nielsbosmans87/bomb-busters/detonator/out/panel_engrave.png

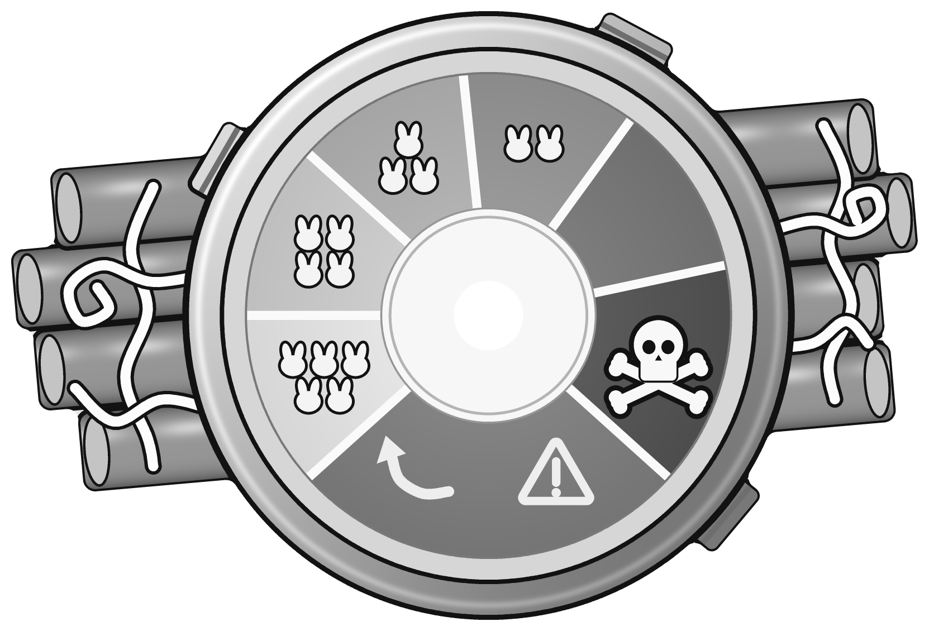
detonator/out/panel_engrave.png
