nielsbosmans87/bomb-busters/docs/picture_detonator.jpg

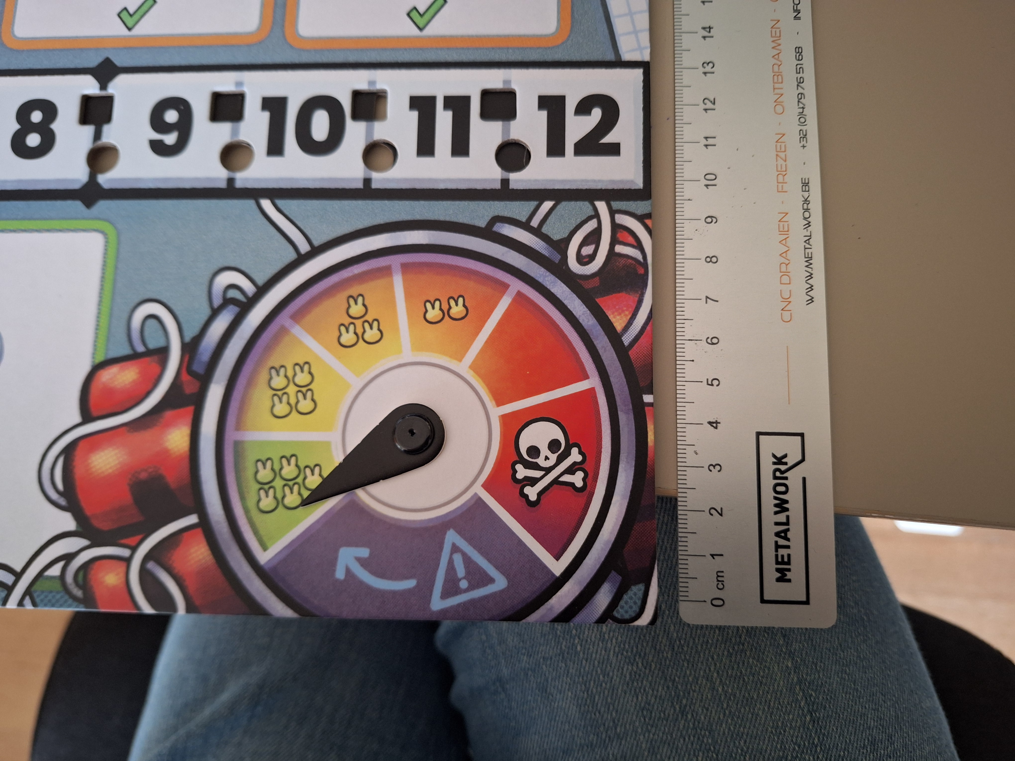
docs/picture_detonator.jpg
