nielsbosmans87/bomb-busters/detonator/cad/detonator.FCStd

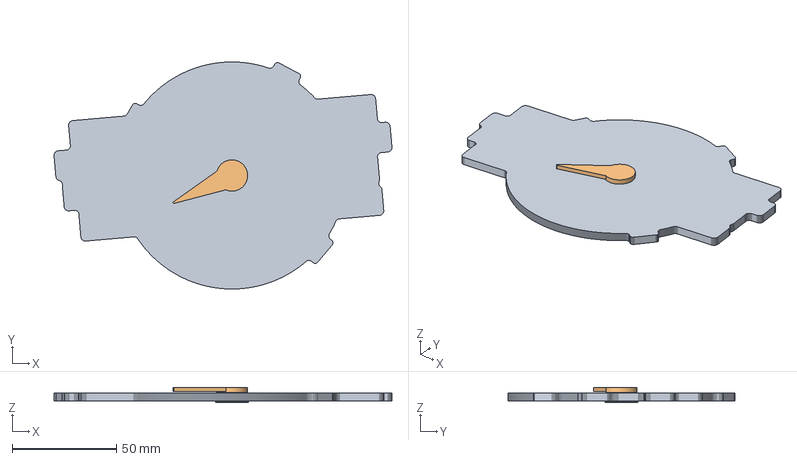
[picture p5: CAD file, 2026-11-01]
detonator/cad/detonator.FCStd
162.3 x 109.0 x 7.20 mm
Panel
ArrowFront
ArrowBack
