nielsbosmans87/bomb-busters/detonator/out/arrow.step

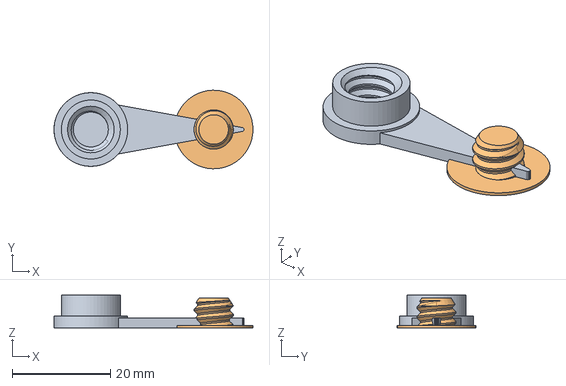
[picture p6: CAD file, 2026-11-01]
detonator/out/arrow.step
40.5 x 16.0 x 6.70 mm
