nielsbosmans87/bomb-busters/detonator/out/arrow_front.stl

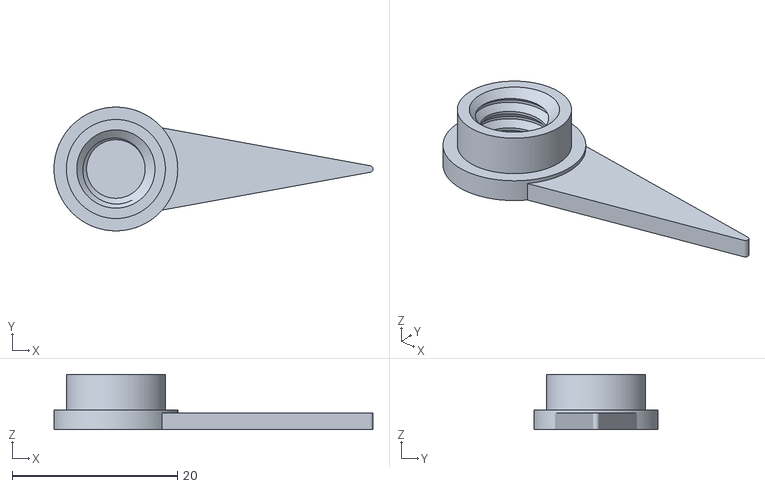
[picture p7: CAD file, 2026-11-01]
detonator/out/arrow_front.stl
38.7 x 15.0 x 6.70
