nielsbosmans87/bomb-busters/detonator/out/thread_test.stl

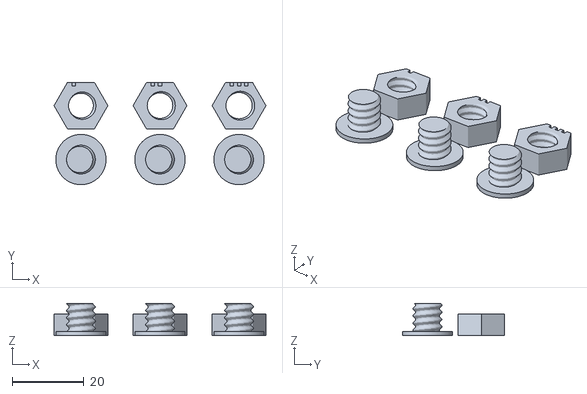
[picture p8: CAD file, 2026-11-01]
detonator/out/thread_test.stl
59.0 x 28.5 x 9.00
