nielsbosmans87/bomb-busters/detonator/out/arrow_back.stl

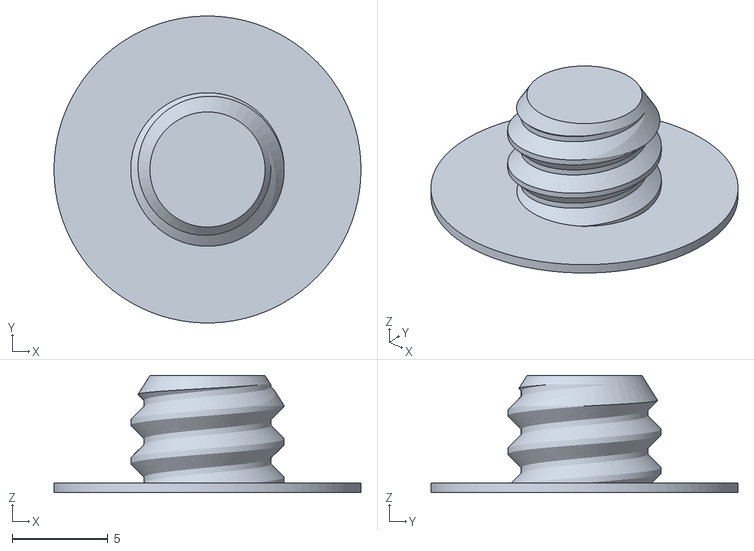
[picture p9: CAD file, 2026-11-01]
detonator/out/arrow_back.stl
16.0 x 16.0 x 6.10
