nielsbosmans87/bomb-busters/detonator/out/preview_assembly.png

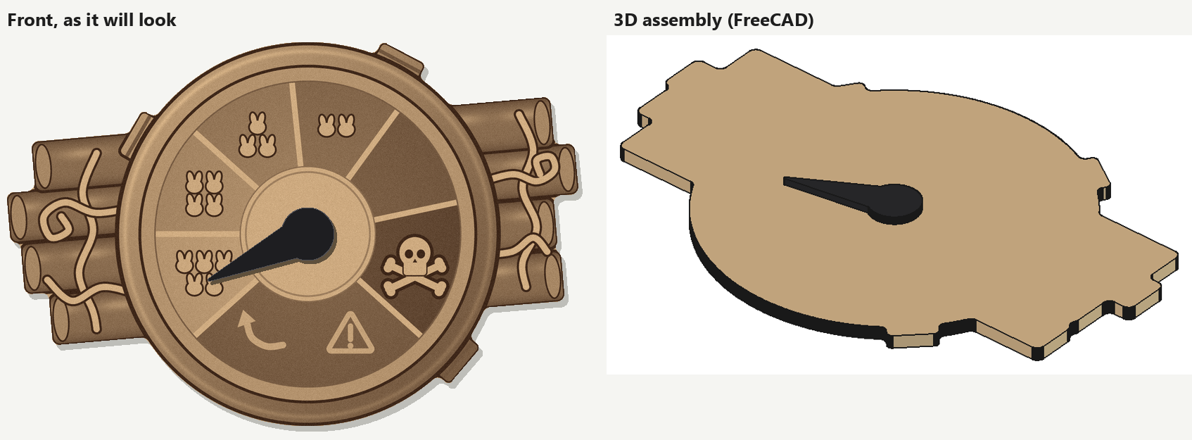
detonator/out/preview_assembly.png
