nielsbosmans87/bomb-busters/detonator/out/tone_test.png

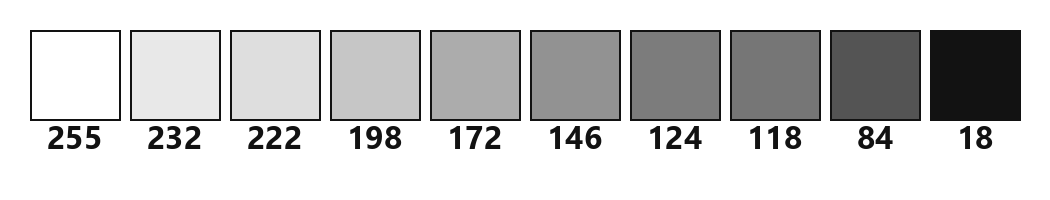
detonator/out/tone_test.png
